wiltomdus/ChuteRelease/(threads)

Thread 10 (2024-10-13):

Replace neopixel with 3.3V compatible RGB LED

wiltomdus, 2024-10-13:

wiltomdus, 2024-10-13:
not needed, neopixel works with 3.3V

Closed 2024-10-13.
