wiltomdus/ChuteRelease/Software/barometer.py

"""Barometer module"""

import board
import busio
from adafruit_dps310.advanced import DPS310_Advanced as DPS310
from adafruit_dps310.advanced import Rate as DPS310_RATE
from adafruit_dps310.advanced import Mode as DPS310_MODE
from adafruit_dps310.advanced import SampleCount as DPS310_SAMPLE_COUNT


class Barometer(object):
    """Altimeter API using the DPS310 sensor"""

    def __init__(self):
        self.i2c = None
        self._sensor = None
        self.init_barometer()

    def init_barometer(self):
        """Initialize settings for the DPS310 sensor"""
        print("Initializing barometer...")
        if self.i2c is None:
            # Initialize the I2C bus if not already initialized
            self.i2c = busio.I2C(board.SCL, board.SDA)

        # Initialize the sensor only once
        if self._sensor is None:
            self._sensor = DPS310(self.i2c)
            self._sensor.reset()
            self._sensor.pressure_oversample_count = DPS310_SAMPLE_COUNT.COUNT_4
            self._sensor.pressure_rate = DPS310_RATE.RATE_128_HZ
            self._sensor.temperature_oversample_count = DPS310_SAMPLE_COUNT.COUNT_4
            self._sensor.temperature_rate = DPS310_RATE.RATE_128_HZ
            self._sensor.mode = DPS310_MODE.CONT_PRESTEMP
            self._sensor.sea_level_pressure = 1024.6  # Set sea level pressure
            self._sensor.wait_temperature_ready()
            self._sensor.wait_pressure_ready()
            print("Barometer initialization finished!")

    def get_sensor_data(self) -> tuple[float, float, float]:
        """Get current sensor data from barometer"""
        return (self._sensor.pressure, self._sensor.altitude, self._sensor.temperature)
