wiltomdus/ChuteRelease/(commit log)

2024-08-26 Initial design of chute release sch and pcb
    [chute_release.kicad_pcb, chute_release.kicad_sch, mcu.kicad_sch, power.kicad_sch, sensors.kicad_sch]
2024-08-29 WIP - Started implementation of selector switch
    [chute_release.kicad_pcb, chute_release.kicad_sch, interface.kicad_sch, mcu.kicad_sch, power.kicad_sch]
2024-08-29 Moved pcb files to Hardware dir
    [chute_release.kicad_pcb, chute_release.kicad_sch, interface.kicad_sch, mcu.kicad_sch, power.kicad_sch, sensors.kicad_sch]
2024-08-29 Pretty much finished pcb routing
    [chute_release.kicad_pcb]
2024-09-02 updated routing
    [chute_release.kicad_pcb]
2024-10-01 Added new components to sch and pcb and redid the routing and layout of pcb
    [chute_release.kicad_pcb, interface.kicad_sch, mcu.kicad_sch, power.kicad_sch, sensors.kicad_sch]
2024-10-01 Changed dev mode detection method Added kalman for accel Tuned kalman filters Fixed flight data logging Updated state machine conditions Implmented a flight number system for log files
    [boot.py, flightManager.py, main.py]
2024-10-01 Removed redundant kicad project in root
2024-10-01 Updated silkscreen on pcb
    [chute_release.kicad_pcb]
2024-10-01 Moved BOOT switch to bottom
    [chute_release.kicad_pcb]
2024-10-01 Added silkscreen for batt and servo polarity, and mode seletor switch
    [chute_release.kicad_pcb]
2024-10-01 Moved VBUS_DETECT from GPIO21 to GPIO19 to follow the rp2040 datasheet, updated some silkscreen
    [chute_release.kicad_pcb, mcu.kicad_sch]
2024-10-01 Added external batt switch pin and bypass 0ohm res, changed ldo for smaller 600mA
    [chute_release.kicad_pcb, interface.kicad_sch, mcu.kicad_sch, power.kicad_sch, sensors.kicad_sch]
2024-10-01 Added servo control Added mock_barometer for testing General Cleaning
2024-10-01 Adjustements of vias and VBATT copper pour
    [chute_release.kicad_pcb, interface.kicad_sch]
2024-10-01 Swapped GND and PWR planes so GND is closer to BOTTOM. Added 1V1 copper pour
    [chute_release.kicad_pcb]
2024-10-01 Fixed bad module import for mock baro in flight manager
    [flightManager.py]
2024-10-01 Added missing adafruit motor lib for servo control
2024-10-01 Added encoded switch logic and release altitude selection Updated logging with more data
2024-10-01 Changed bat charge current to 100mA
    [chute_release.kicad_pcb, power.kicad_sch]
2024-10-01 Extended kalman filter functionality to allow multiple sensors and more
2024-10-01 Board review fixes
    [chute_release.kicad_pcb, mcu.kicad_sch]
2024-10-02 Added silkscreen box to allow board number to be written
    [chute_release.kicad_pcb]
2024-10-02 Changed bat sw footprint to header 2.54mm pitch. Adjusted silkscreens.
    [chute_release.kicad_pcb]
2024-10-02 Fixed batt sw bypass silkscreen position
    [chute_release.kicad_pcb]
